liuhuihou/new_2024H/报告图/page1-1.png

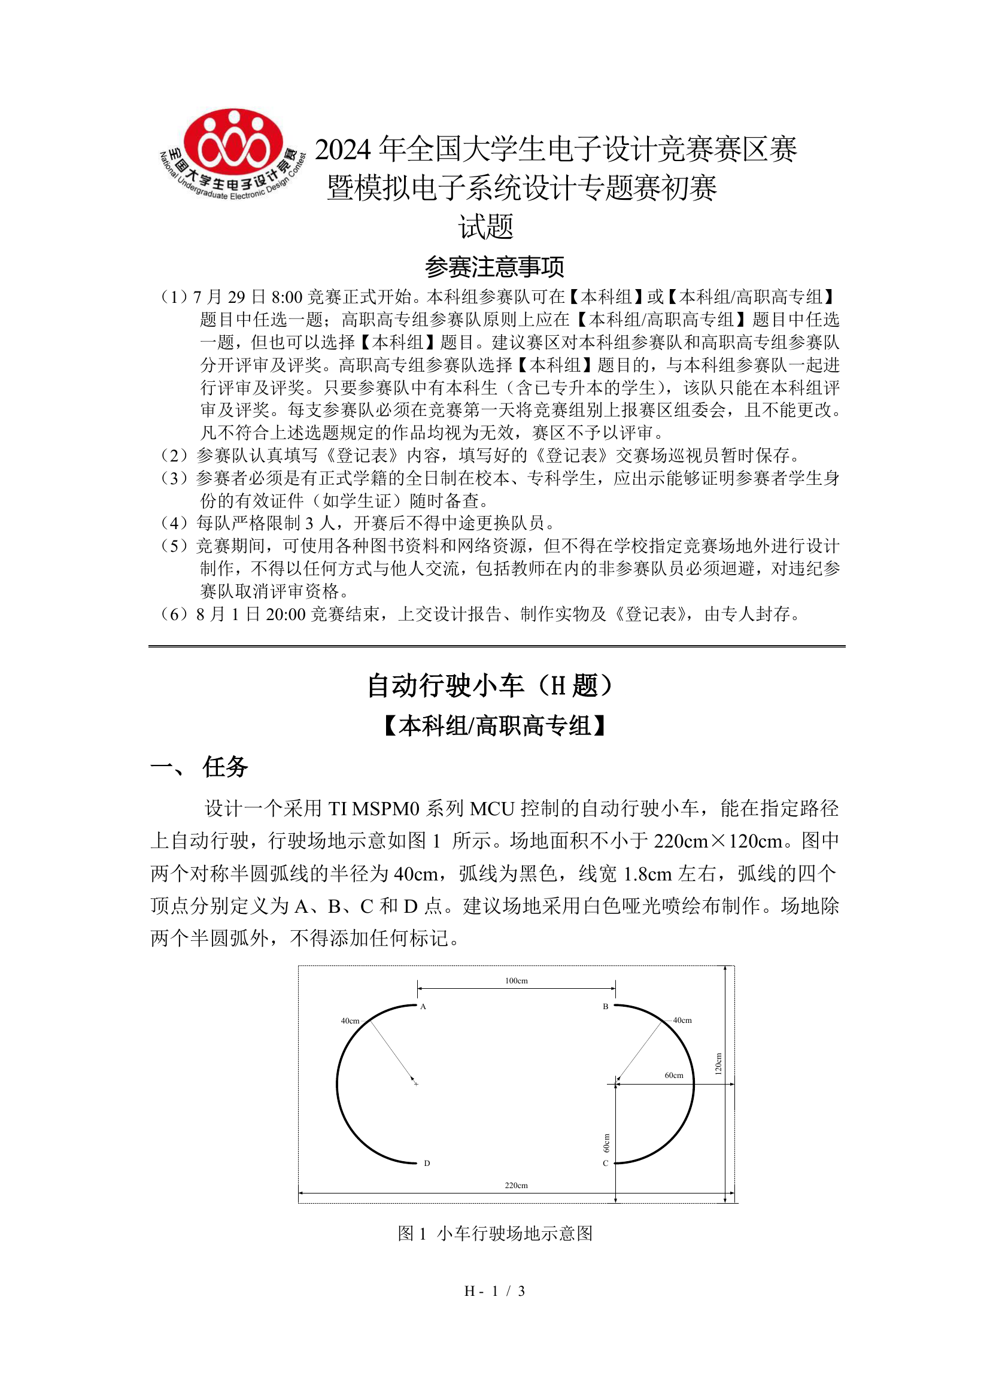
报告图/page1-1.png
