liuhuihou/new_2024H/(commit log)

2026-06-22 2024 电赛 H 题自动行驶小车：MSPM0G3507 工程初版
    - 4 路红外巡线 + 双轮编码器感知
    - 双环串级控制（外环 巡线PD/航向PD，内环 每轮 PI 速度环）
    - 事件驱动路径状态机（直线↔巡线，不写死里程）
    - UART0 在线 PID 调参；LED+串口声光提示
    - Keil 编译通过（ARMCLANG V6.21，0 错 0 警）
    - 含设计报告与 README
    [MSPM0_SDK_syscfg_menu_import.cfg]
2026-06-23 添加屏幕显示
2026-06-23 添加屏幕显示，修改线路识别高低电平
2026-06-23 修正第二问
